W4KRL/ESP32-C3-EV-Charger-HA-MQTT/assets/stripboard/WX-DC12003_dims.jpg

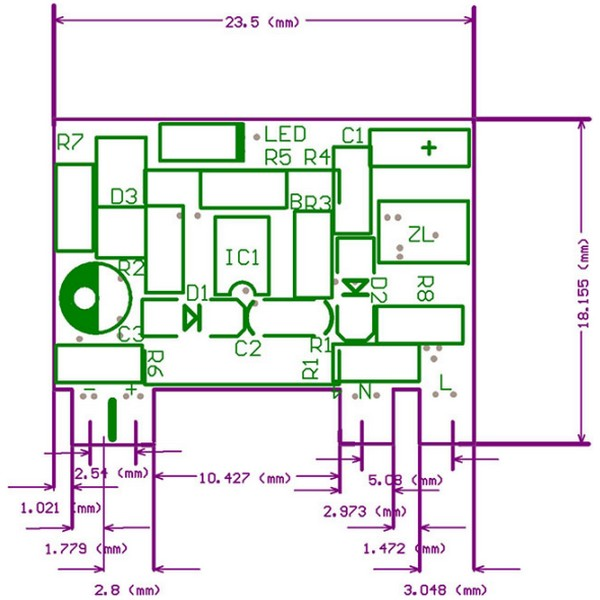
assets/stripboard/WX-DC12003_dims.jpg
