W4KRL/ESP32-C3-EV-Charger-HA-MQTT/assets/photos/AC_Monitor_04.jpg

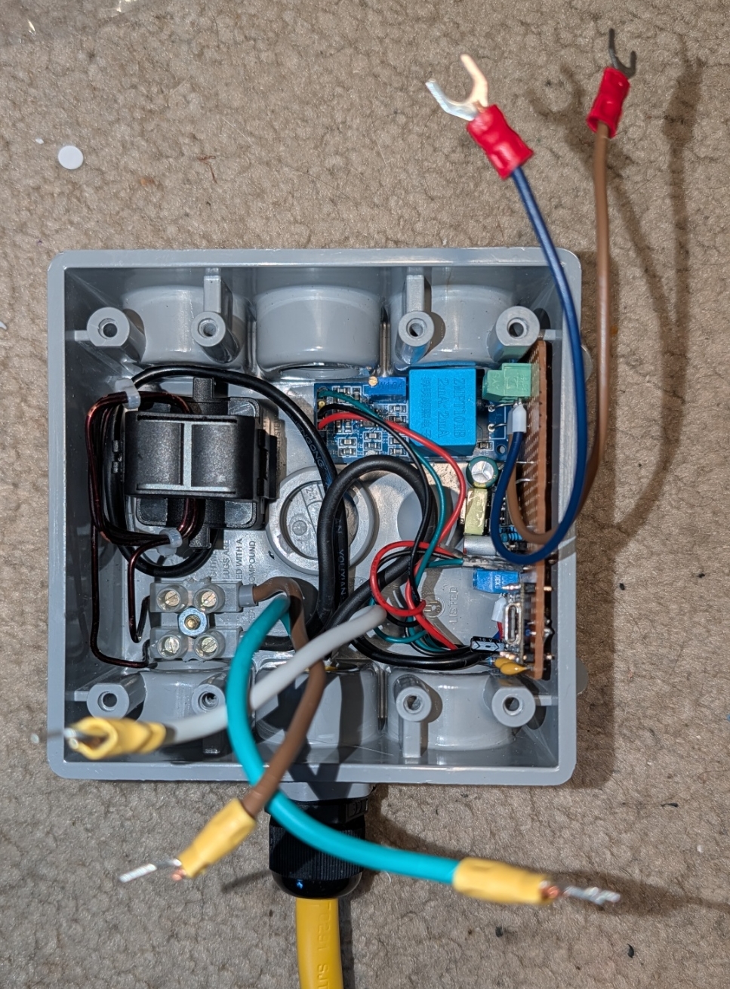
assets/photos/AC_Monitor_04.jpg
