W4KRL/ESP32-C3-EV-Charger-HA-MQTT/assets/stripboard/ac_monitor_stripboard.pdf

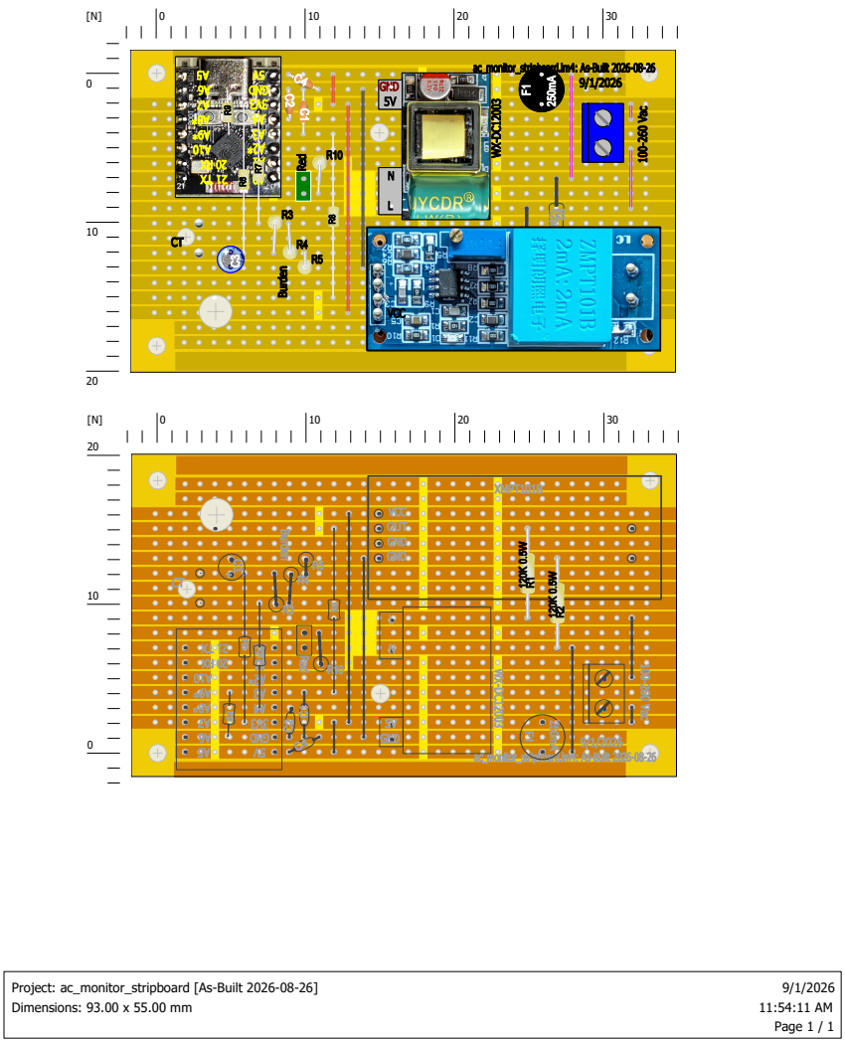
[picture p6: page 1]
9/1/2026 11:54:11 AM Page 1 / 1

Project: ac_monitor_stripboard [As-Built 2026-08-26]
Dimensions: 93.00 x 55.00 mm
