W4KRL/ESP32-C3-EV-Charger-HA-MQTT/assets/schematic/ac_monitor_schematic.pdf

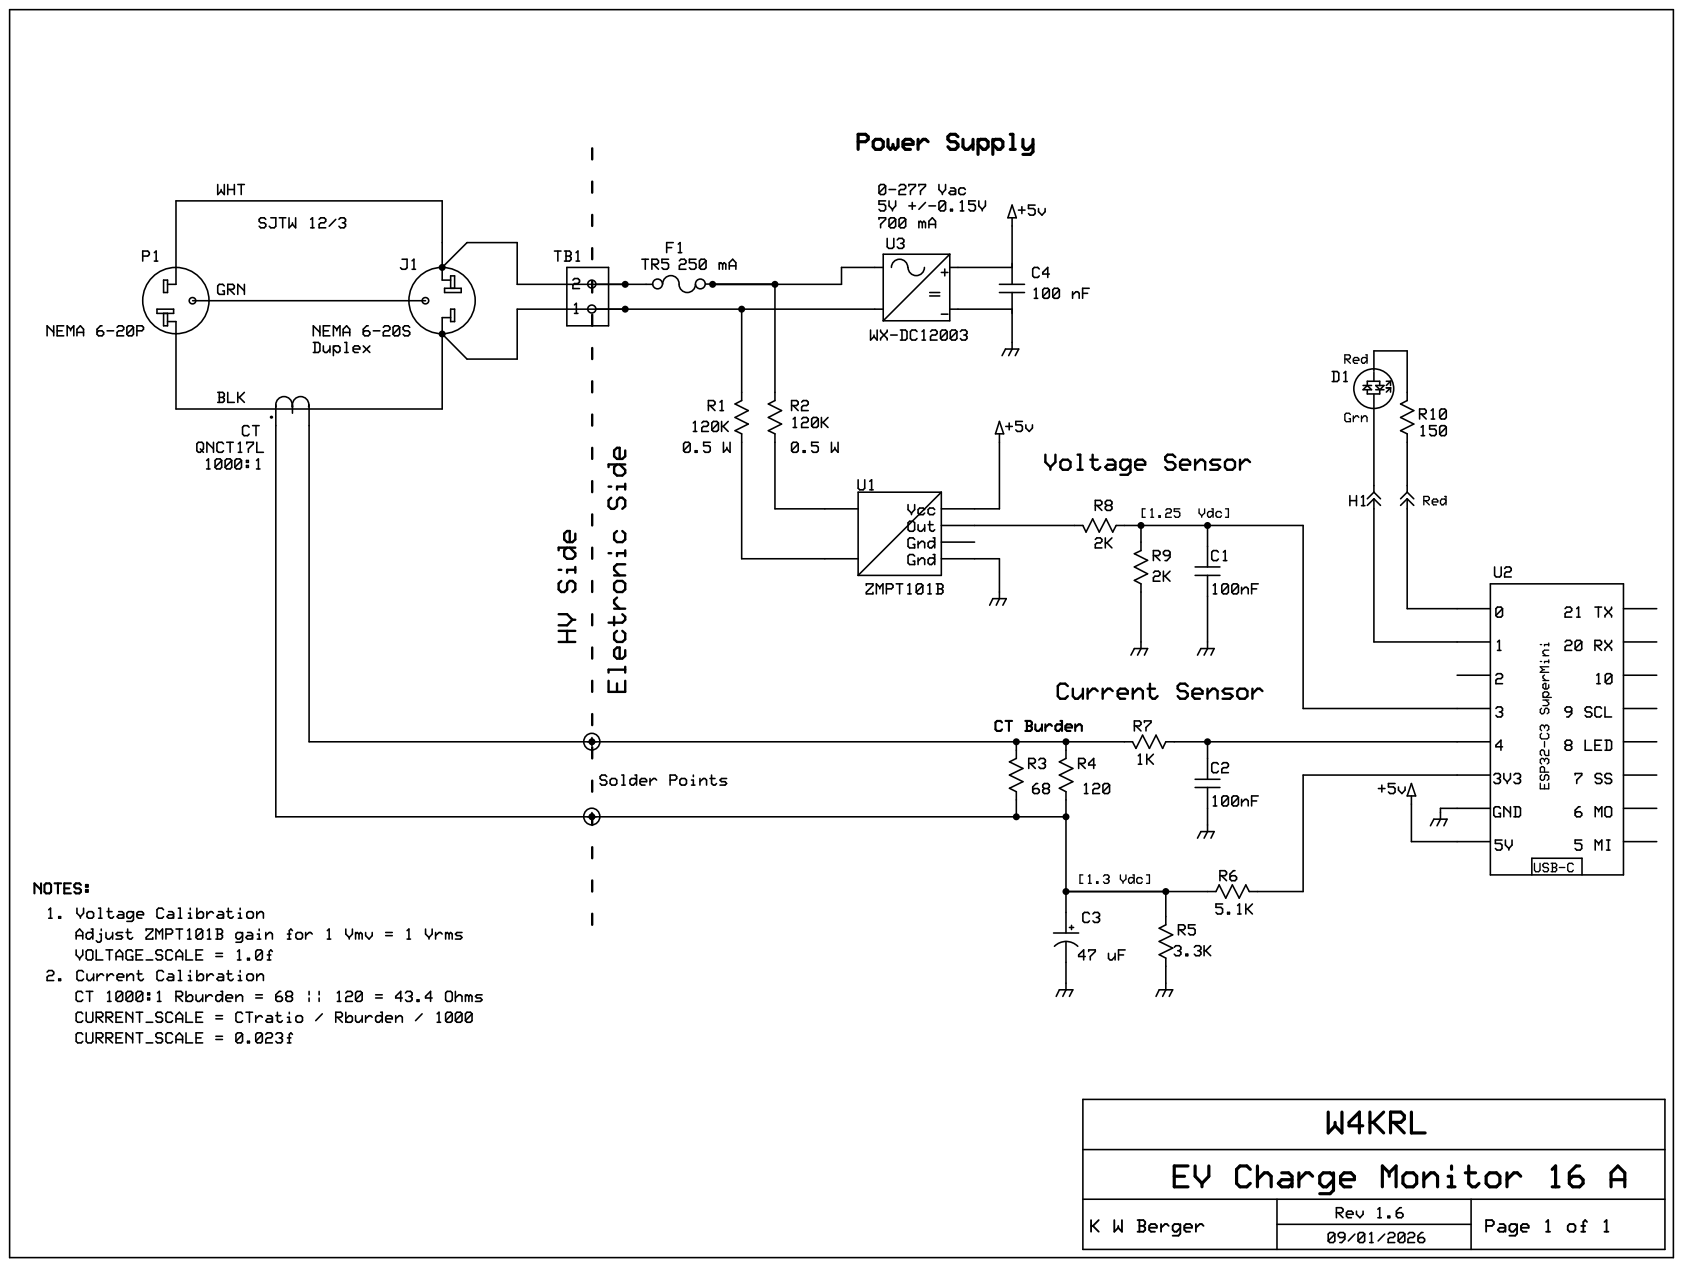
[picture p7: page 1]
