W4KRL/ESP32-C3-EV-Charger-HA-MQTT/assets/schematic/ac_monitor_future_build_schematic.pdf

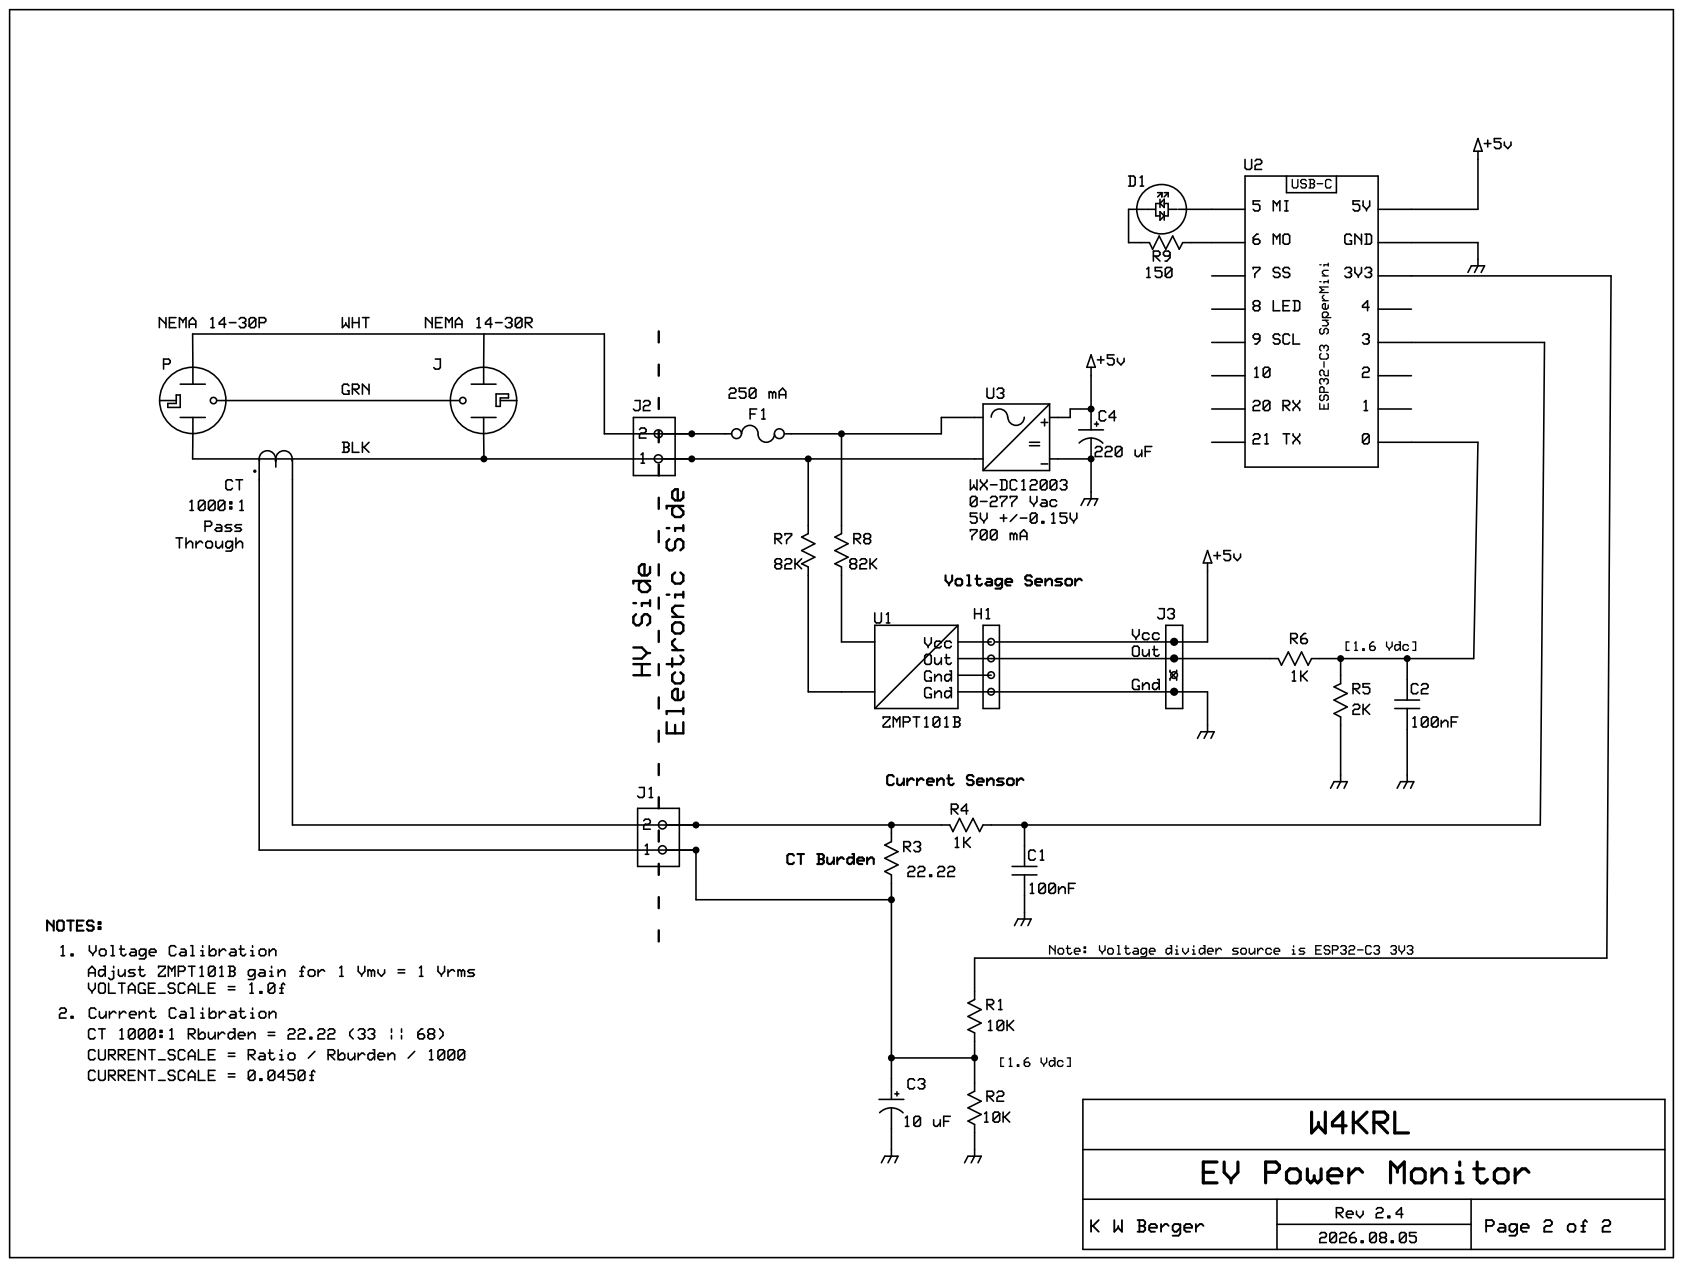
[picture p8: page 1]
