W4KRL/ESP32-C3-EV-Charger-HA-MQTT/(commit log)

2026-07-07 Add schematic, stripboard layout, parts list, and photos.
2026-07-09 Add state class to SensorDef
2026-07-10 Clean and conform
    [HA-ESP32C3-MQTT-EV-Power-Monitor.sch]
2026-07-10 Supress clang format, fix typo
    [alertFlash.h]
2026-07-11 Raise CURRENT_DEABAND
2026-07-22 reworked for TickTwo timers
    [alertFlash.cpp]
2026-07-22 Refactor for single TickTwo timer for publishReading intervals. Update doxygen for TickTwo
2026-07-22 Update as-built schematic and stripboard
    [HA-ESP32C3-MQTT-EV-Power-Monitor.sch]
2026-07-24 Fix micros() rollover in BURST while loop, make BURST unsigned long
    [measurement.cpp]
2026-07-25 Enhance ESP32-C3 SuperMini description in README
    Updated description of ESP32-C3 SuperMini development board.
2026-07-25 Update to as-built
    [HA-ESP32C3-MQTT-EV-Power-Monitor.sch, ac_monitor_schematic.sch]
2026-07-25 Clarify resistor and stripboard descriptions
    Updated descriptions for resistors R7 and R8, and clarified stripboard details.
2026-07-25 Specify model number for enclosure box
    Updated the model number for the weatherproof enclosure box.
2026-07-25 Update README with design software links
    Added links for schematic and stripboard design software.
2026-07-25 Fix links in README for schematic and stripboard design
    Corrected formatting and updated links for schematic and stripboard design.
2026-07-25 Fix links in README for schematic and stripboard design
2026-07-25 Update links for schematic and stripboard design
2026-07-26 Update as-built details
    [ac_monitor_schematic.sch]
2026-07-27 Reorganize file structure similar to PlatformIO
    [ac_monitor_schematic.sch]
2026-07-28 Add forceUpdate field to sensor definitions
2026-07-31 Migrate project structure from Arduino IDE to PlatformIO
2026-07-31 Increase MQTT buffer to 768 bytes to fix discovery payload truncation
    [mqttConnection.h]
2026-08-01 Reduce CURRENT_DEADBAND_A to match reduced hardware noise floor
    [config.h]
2026-08-01 Add link to future schematic
2026-08-01 Update as-built
    [ac_monitor_schematic.sch]
2026-08-01 Fix markdown link to future schematic
2026-08-06 Update schematics
    [ac_monitor_schematic.sch]
2026-08-06 Update chematics
    [ac_monitor_schematic.sch]
2026-08-21 add new build schematic
2026-08-21 bump firmware version to 1.3.4 and update SAMPLE_CYCLES for improved performance
2026-08-21 update firmware version note and reduce SAMPLE_CYCLES to 15
2026-08-27 update pin assignments for voltage, current, and LED connections in config.h
2026-08-31 refactor WX-DC12003 specifications for clarity; remove outdated files and update schematic
2026-09-27 Latest schematics
2026-09-27 modified: assets/schematic/ac_monitor_schematic.sch modified: assets/stripboard/ac_monitor_stripboard.lm4
2026-10-16 Update schematic
